uscmakers/SunshineSleepMask/README.md

## 🎞️ Project presentation



Walk through the project in the [interactive Google Slides presentation](https://docs.google.com/presentation/d/1asSZadhyUf5sEbis1G4J2R6rxChlyDanlBMHeCqUoIE/edit?usp=sharing).

## 🎞️ Presentation

## 📸 Project gallery

| | |
|:---:|:---:|
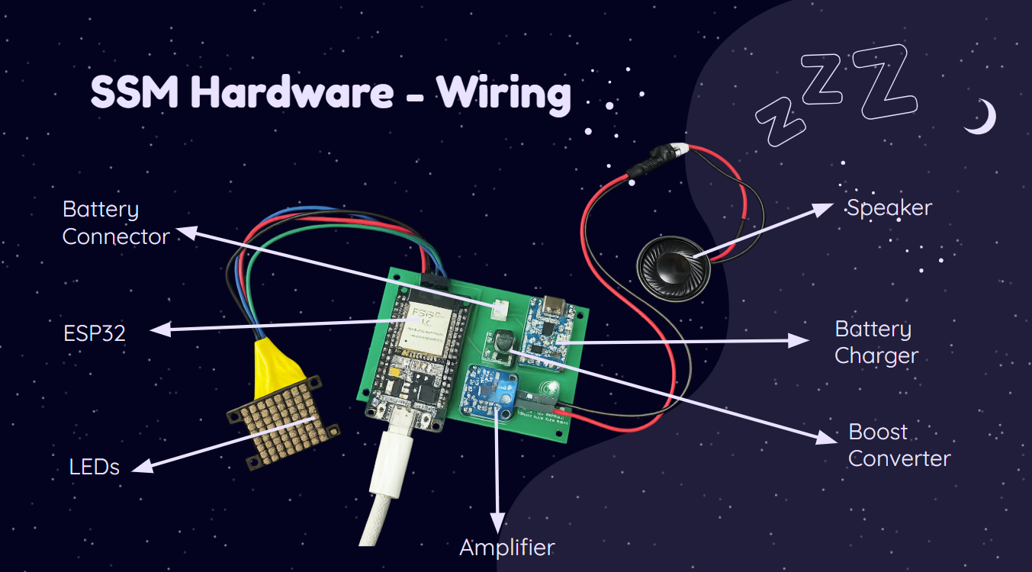
[picture p1: Captura de pantalla 2026-10-10 094715.png]
Sunshine Sleep Mask image 1
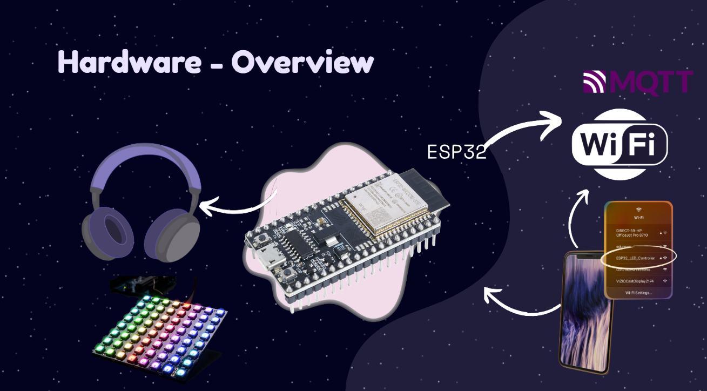
[picture p2: Captura de pantalla 2026-10-10 094737.png]
Sunshine Sleep Mask image 2
|  |  |
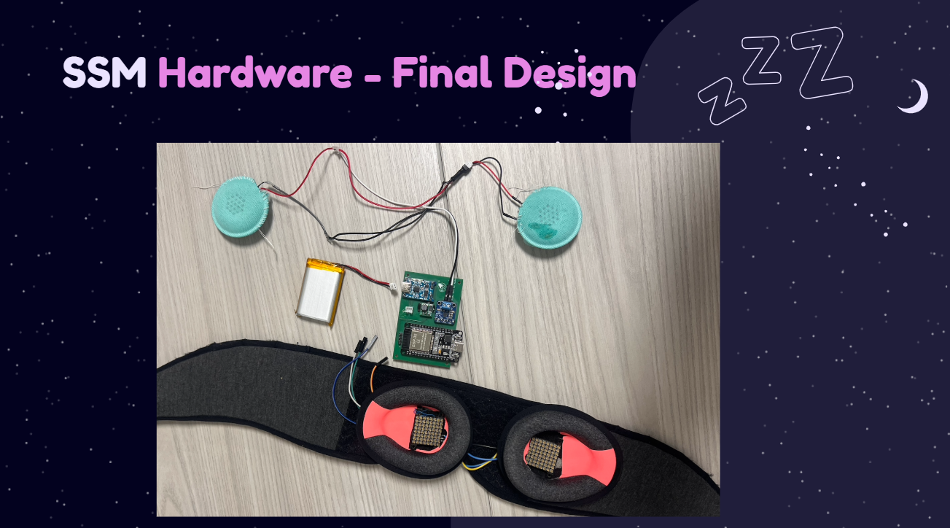
[picture p3: Captura de pantalla 2026-10-10 094751.png]
Sunshine Sleep Mask image 3
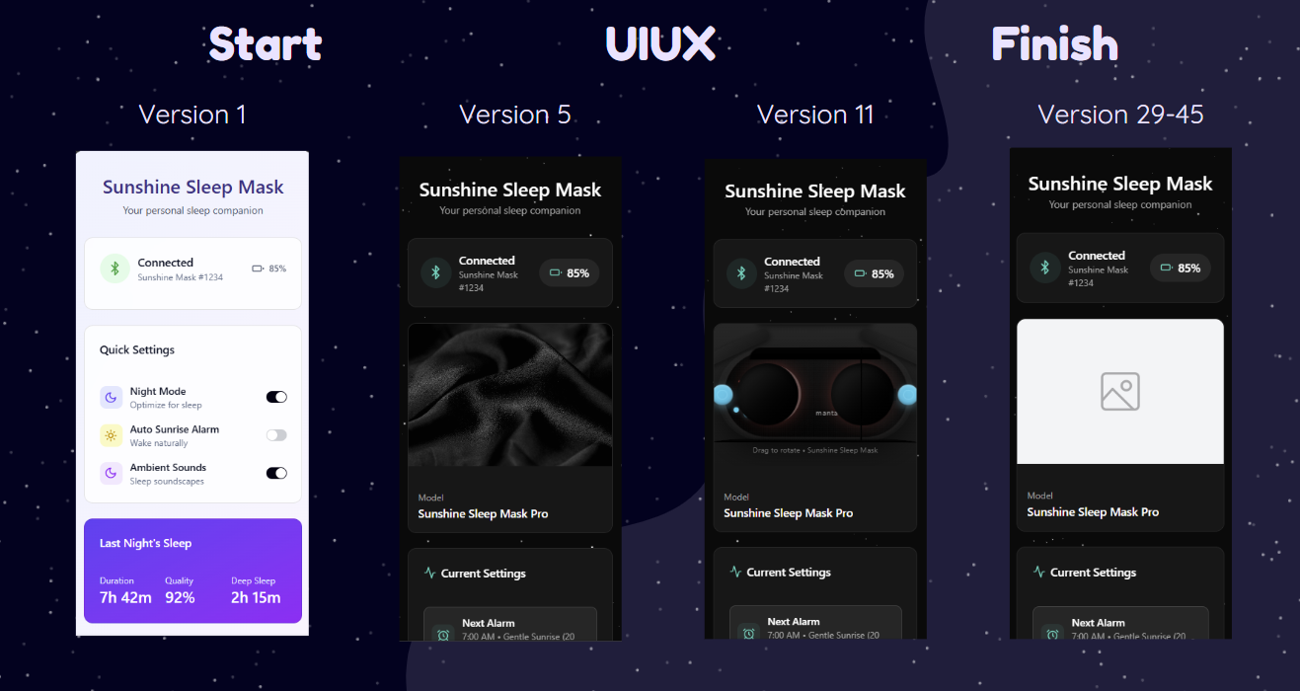
[picture p4: Captura de pantalla 2026-10-10 094804.png]
Sunshine Sleep Mask image 4
|  |  |
