uscmakers/SunshineSleepMask/Sunshine Sleep Mask PCB/0104-pcb/Downloaded Footprints/TP4056_module-main/README.md

# TP4056_module

I have searched countless footprint of TP4056 module for type c but there isnt a correct one like some have incorrect dimension, so i made
one myself with correct dimensions.

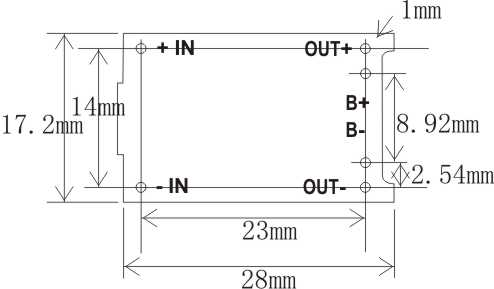
[picture p5: Sunshine Sleep Mask PCB/0104-pcb/Downloaded Footprints/TP4056_module-main/image.png]
dimensions


*src: https://forum.fritzing.org/t/tp4056-charger-board/4795*
