uscmakers/SunshineSleepMask/mobile/assets/images/mask-product.png

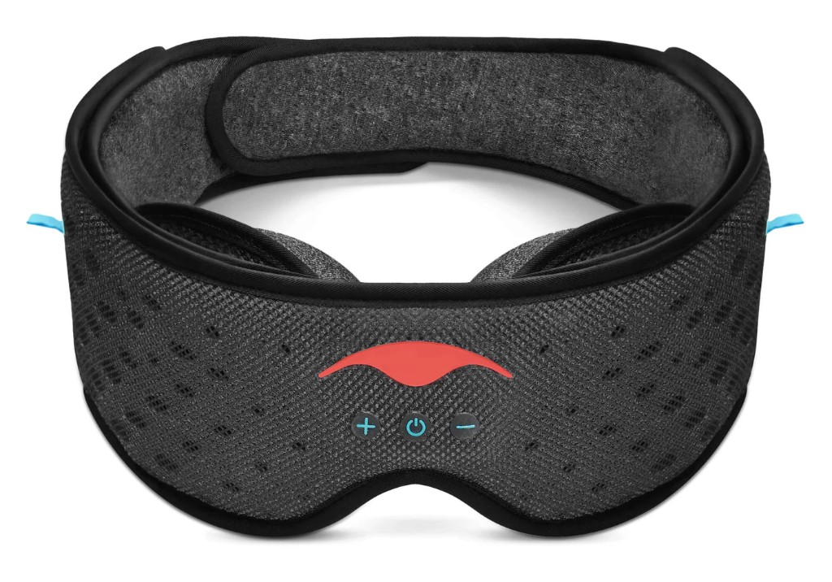
mobile/assets/images/mask-product.png
