uscmakers/SunshineSleepMask/Sunshine Sleep Mask PCB/0104-pcb/Downloaded Footprints/TP4056_module-main/footprint.png

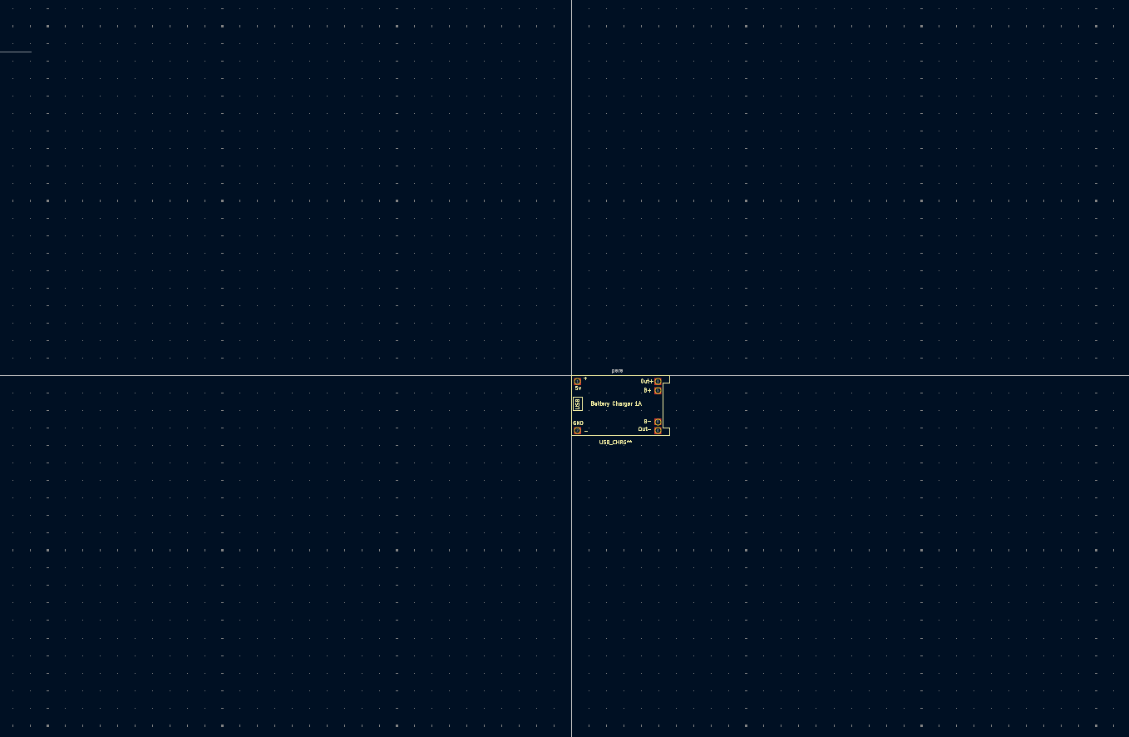
Sunshine Sleep Mask PCB/0104-pcb/Downloaded Footprints/TP4056_module-main/footprint.png
