uscmakers/SunshineSleepMask/Sunshine Sleep Mask PCB/0104-pcb/0104-pcb.kicad_pcb

## KiCad design Sunshine Sleep Mask PCB/0104-pcb/0104-pcb.kicad_pcb (2026-04-08)

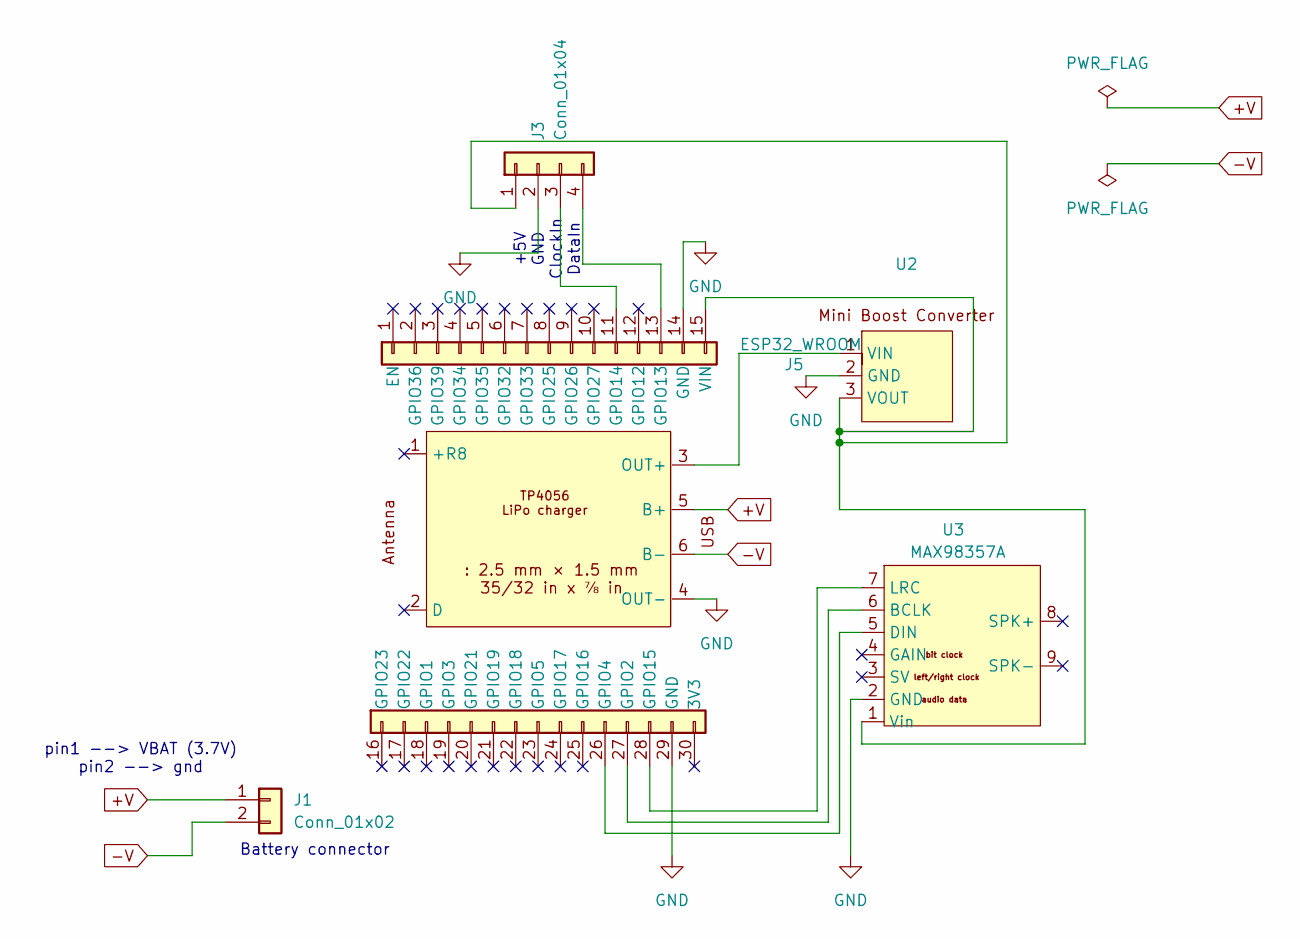
[picture p8: schematic 0104-pcb.kicad_sch]

Parts:
J1: Conn_01x02; JST_PH_B2B-PH-K_1x02_P2.00mm_Vertical
J3: Conn_01x04; PinHeader_1x04_P2.54mm_Vertical
J5: ESP32_WROOM; ESP32_WROOM_DevKit_30Pin_Custom
U1: TP4056-18650
U2: Boost_Converter_Clay_Custom
U3: MAX98357A; adafruit-MAX98357

Connections:
+V: J1.1, U1.5 (B+)
-V: J1.2, U1.6 (B-)
GND: J3.2, J5.14 (GND), J5.29 (GND), U1.4 (OUT-), U2.2 (GND), U3.2 (GND)
unnamed: J3.1, J5.15 (VIN), U2.3 (VOUT), U3.1 (Vin)
unnamed: J3.3, J5.11 (GPIO14)
unnamed: J3.4, J5.13 (GPIO13)
unnamed: J5.27 (GPIO2), U3.6 (BCLK)
unnamed: J5.26 (GPIO4), U3.5 (DIN)
unnamed: J5.28 (GPIO15), U3.7 (LRC)
unnamed: U1.3 (OUT+), U2.1 (VIN)

Notes on the sheet:
Battery connector
+5V GND ClockIn DataIn
pin1 --> VBAT (3.7V) pin2 --> gnd

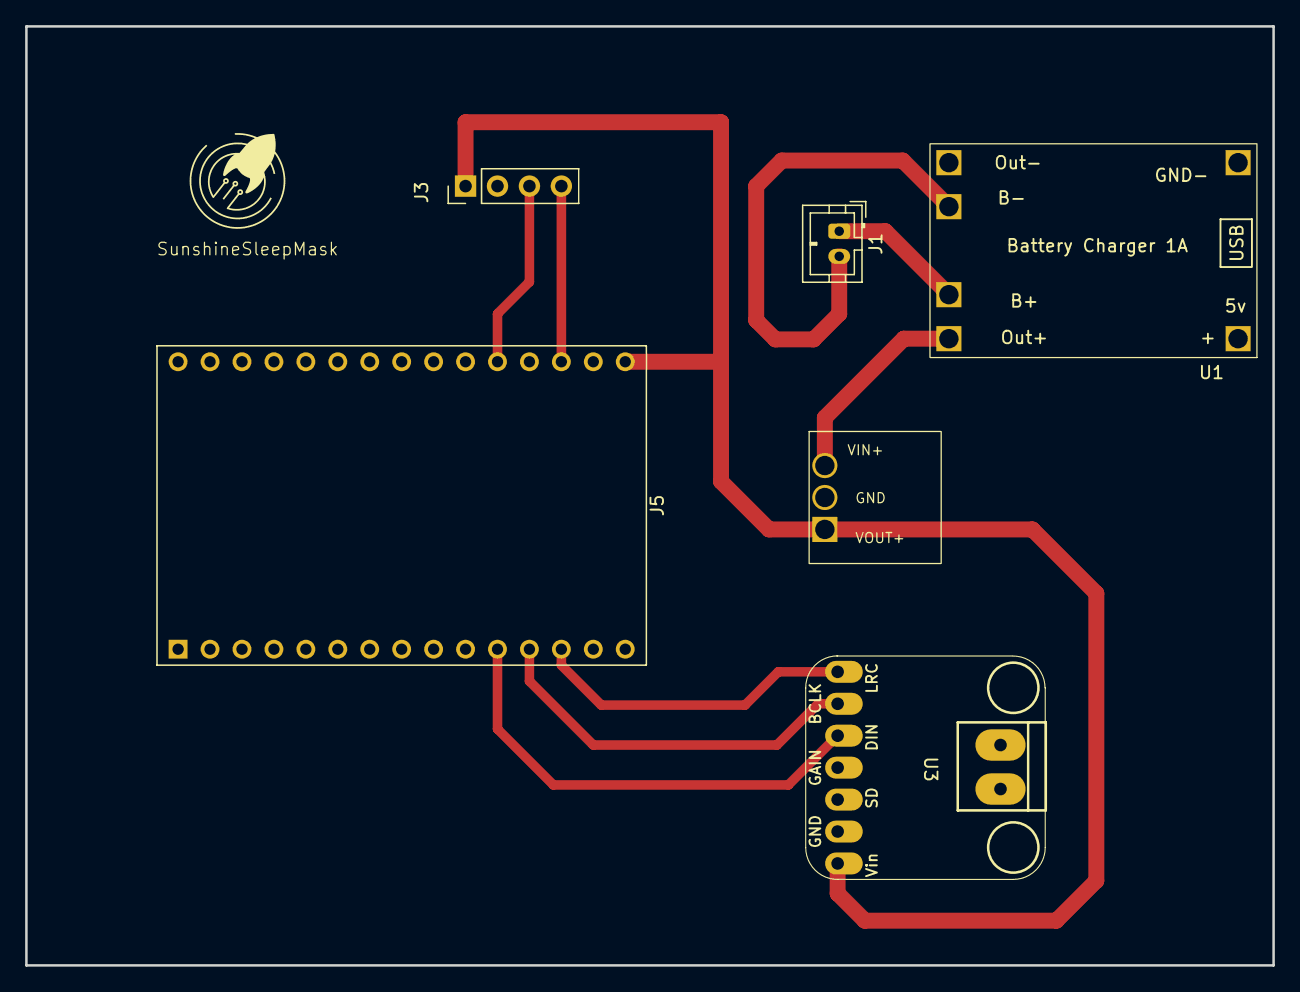
[picture p9: board 0104-pcb.kicad_pcb from above]

Board: 2 copper layers, 99.2 x 74.7 mm, 6 parts (0 on the bottom side), 10 nets.
