uscmakers/SunshineSleepMask/Sunshine Sleep Mask PCB/0104-pcb/0407-Original-Layout.kicad_pcb

## KiCad design Sunshine Sleep Mask PCB/0104-pcb/0407-Original-Layout.kicad_pcb (2026-04-08)

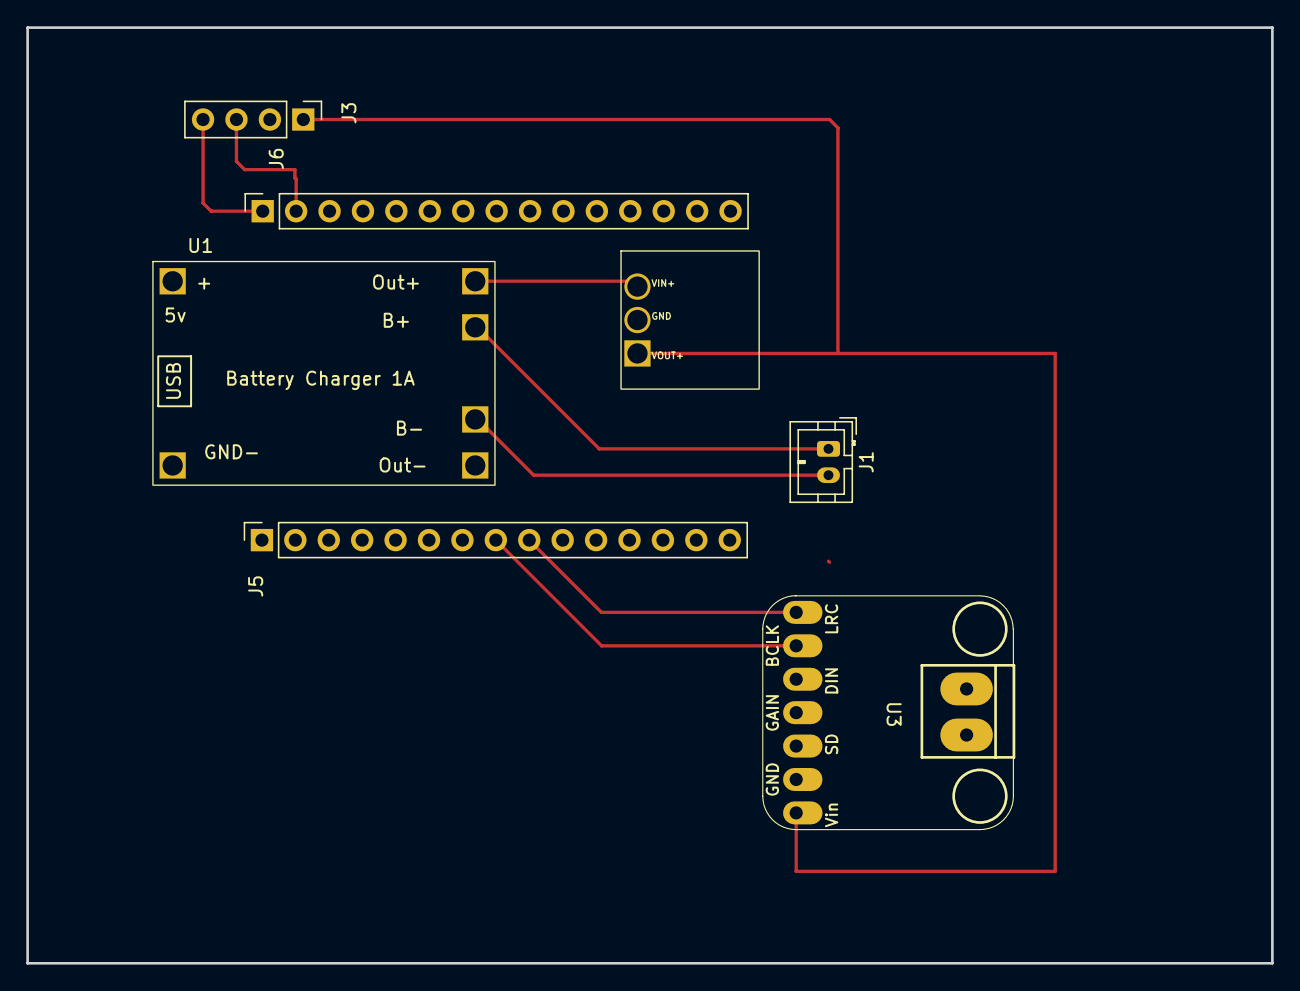
[picture p10: board 0407-Original-Layout.kicad_pcb from above]

Board: 2 copper layers, 94.6 x 71.1 mm, 7 parts (0 on the bottom side), 11 nets.

Parts:
J1: Conn_01x02; JST_PH_B2B-PH-K_1x02_P2.00mm_Vertical
J3: Conn_01x04; PinHeader_1x04_P2.54mm_Vertical
J5, J6: Conn_01x15; PinSocket_1x15_P2.54mm_Vertical
U1: TP4056-18650
U2: Boost_Converter_Clay_Custom
U3: MAX98357A; adafruit-MAX98357

Connections:
+V: J1.1, U1.5 (B+)
-V: J1.2, U1.6 (B-)
unnamed: J3.1, U2.3 (VOUT), U3.1 (Vin)
unnamed: J3.2, J5.14, U3.2 (GND)
unnamed: J3.3, J6.2
unnamed: J3.4, J6.1
unnamed: J5.8, U3.6 (BCLK)
unnamed: J5.9, U3.7 (LRC)
unnamed: J5.10, U3.5 (DIN)
unnamed: U1.3 (OUT+), U2.1 (VIN)
unnamed: U1.4 (OUT-), U2.2 (GND)
