uscmakers/SunshineSleepMask/(commit log)

2025-10-21 feat: initial color wheel
2026-02-24 Switch LED driver from NeoPixel (WS2812) to APA102 DotStar
2026-03-24 update matrix LED code
2026-03-24 Add KiCad project files
    [Sunshine Sleep Mask PCB.kicad_pcb, Sunshine Sleep Mask PCB.kicad_sch]
2026-03-24 Adding Instructions
    [Sunshine Sleep Mask PCB.kicad_sch]
2026-03-31 add schematics
    rae, clay, march 30th
    [Sunshine Sleep Mask.kicad_pcb, Sunshine Sleep Mask.kicad_sch]
2026-04-01 Clay 03/31 Edits
    [Sunshine Sleep Mask Schematic - Clay 03:31.kicad_sch]
2026-04-01 Renamed file
    [Sunshine Sleep Mask Schematic Clay 0331.kicad_sch]
2026-04-03 0104- pcb + customized footprint
    I created a new pcb editor + schematic where I copied the clay-0331. Then I made 3 customized footprints for the amplifier, charger LiPo, and for the boost converter. Similarly I was able to wire them in the pcb editor, yet there seems to be errors with the pcb constrains
    [0104-pcb.kicad_pcb, 0104-pcb.kicad_sch, Adafruit MAX98357 Breakout.brd, Adafruit MAX98357 Breakout.kicad_pcb, Sunshine Sleep Mask Schematic Clay 0331.kicad_sch]
2026-04-03 added the makers logo
    makers logo in 0.3x0.3in
    [0104-pcb.kicad_pcb]
2026-04-07 GM
    We meet with ray, we changed the wiring and we also realized we had issue with the pin connections
    [0104-pcb.kicad_pcb]
2026-04-08 Clay 0408 Changes
    [0104-pcb.kicad_pcb, 0104-pcb.kicad_sch, 0407-Original-Layout.kicad_pcb, Adafruit MAX98357 Breakout.kicad_pcb, Adafruit MAX98357 Custom.kicad_pcb]
2026-04-09 7:30 04/08
    [0104-pcb.kicad_sch]
2026-04-09 Newest PCB
2026-04-09 New PCB
2026-04-09 updated arduino code - LED and sound combined
2026-04-21 updated pcb pins
2026-04-26 Added Short Relaxation and Sunshine Simulation Code
    [mask_microcontroller.ino]
2026-04-26 Refine alarm screen, LED settings behavior, and audio UI
2026-05-01 shorter than 5 min
    [combined.ino, mask_microcontroller.ino]
